SprInec/ei-tracking-car/电磁循迹小车赛后总结.assets/ADC配置1.png

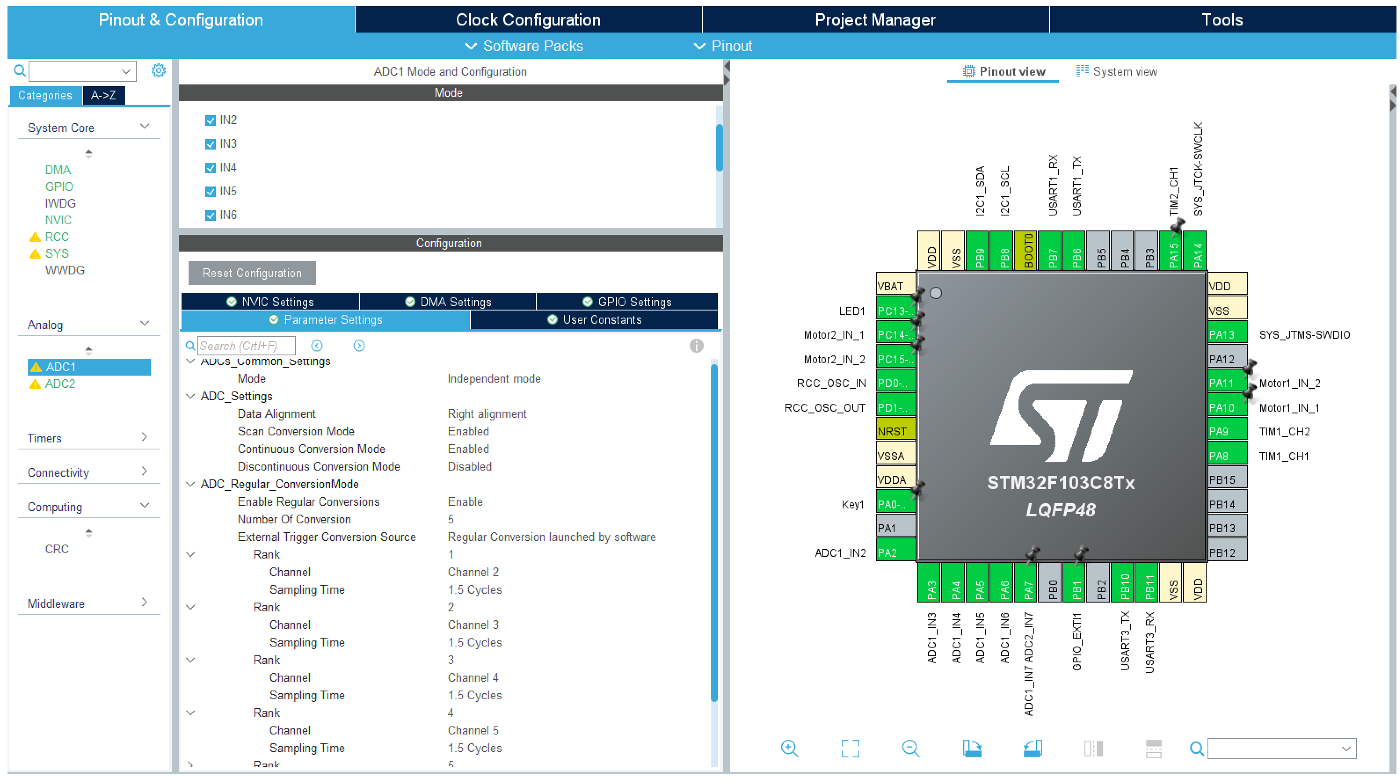
电磁循迹小车赛后总结.assets/ADC配置1.png
