SprInec/ei-tracking-car/AIEiTraceCar.ioc

Mcu.UserName=STM32F103C8Tx
PA0-WKUP.GPIO_Label=Key1
PA0-WKUP.Signal=GPXTI0
PA10.GPIO_Label=Motor1_IN_1
PA10.Signal=GPIO_Output
PA11.GPIO_Label=Motor1_IN_2
PA11.Signal=GPIO_Output
PA13.Signal=SYS_JTMS-SWDIO
PA14.Signal=SYS_JTCK-SWCLK
PA15.Signal=S_TIM2_CH1_ETR
PA2.Signal=ADCx_IN2
PA3.Signal=ADCx_IN3
PA4.Signal=ADCx_IN4
PA5.Signal=ADCx_IN5
PA6.Signal=ADCx_IN6
PA7.Signal=ADCx_IN7
PA8.Signal=S_TIM1_CH1
PA9.Signal=S_TIM1_CH2
PB1.Signal=GPXTI1
PB10.Signal=USART3_TX
PB11.Signal=USART3_RX
PB6.Signal=USART1_TX
PB7.Signal=USART1_RX
PB8.Signal=I2C1_SCL
PB9.Signal=I2C1_SDA
PC13-TAMPER-RTC.GPIO_Label=LED1
PC13-TAMPER-RTC.Signal=GPIO_Output
PC14-OSC32_IN.GPIO_Label=Motor2_IN_1
PC14-OSC32_IN.Signal=GPIO_Output
PC15-OSC32_OUT.GPIO_Label=Motor2_IN_2
PC15-OSC32_OUT.Signal=GPIO_Output
PD0-OSC_IN.Signal=RCC_OSC_IN
PD1-OSC_OUT.Signal=RCC_OSC_OUT
