SprInec/ei-tracking-car/Core/Inc/main.h

#define LED1_Pin GPIO_PIN_13
#define LED1_GPIO_Port GPIOC
#define Motor2_IN_1_Pin GPIO_PIN_14
#define Motor2_IN_1_GPIO_Port GPIOC
#define Motor2_IN_2_Pin GPIO_PIN_15
#define Motor2_IN_2_GPIO_Port GPIOC
#define Key1_Pin GPIO_PIN_0
#define Key1_GPIO_Port GPIOA
#define Key1_EXTI_IRQn EXTI0_IRQn
#define Motor1_IN_1_Pin GPIO_PIN_10
#define Motor1_IN_1_GPIO_Port GPIOA
#define Motor1_IN_2_Pin GPIO_PIN_11
#define Motor1_IN_2_GPIO_Port GPIOA
