SprInec/ei-tracking-car/(notices)

Notices in the files:
Core/Src/adc.c:
Copyright (c) 2022 STMicroelectronics.
All rights reserved.
This software is licensed under terms that can be found in the LICENSE file
